fahmimsh/FlowMeter-ESP32-Slave-RP2040-Master/Hardware_Design/master.pdf

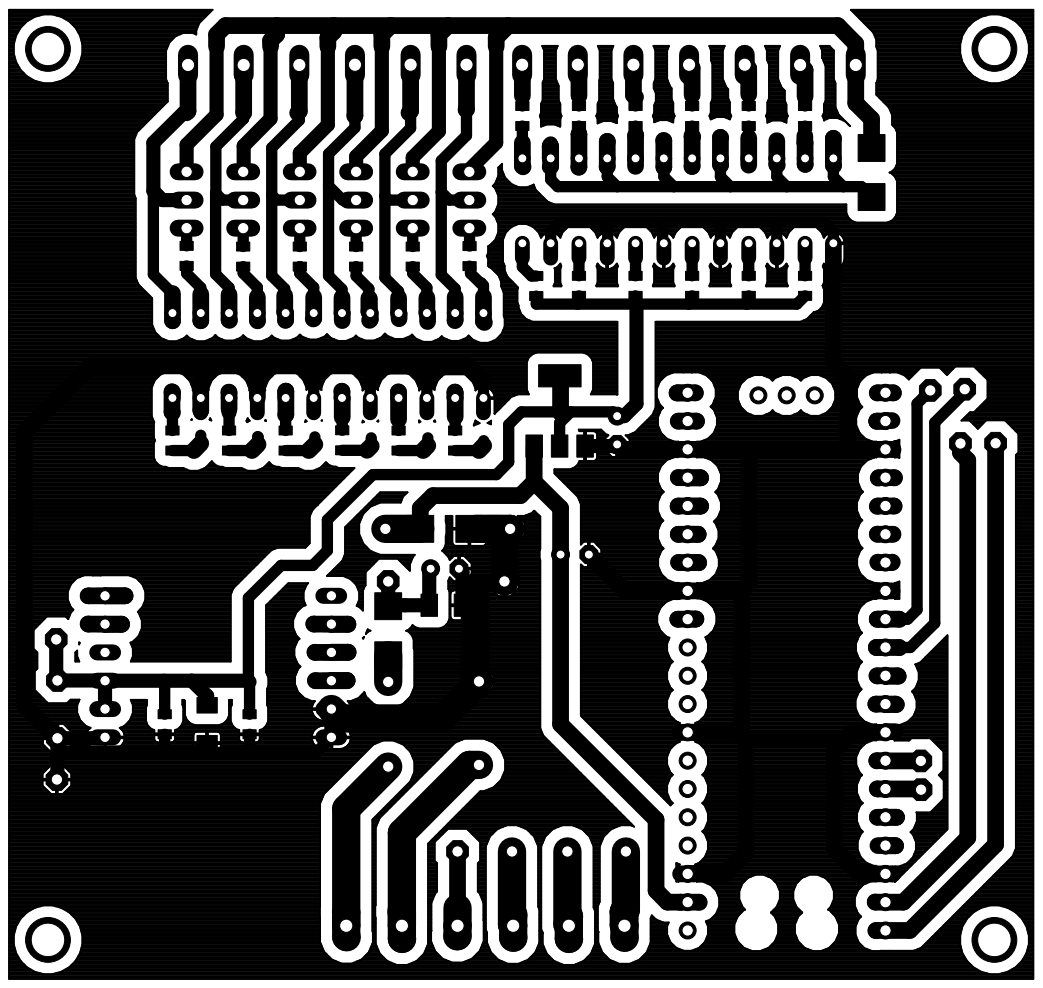
[picture p23: page 1]
