fahmimsh/FlowMeter-ESP32-Slave-RP2040-Master/Hardware_Design/SlaveMCU.pdf

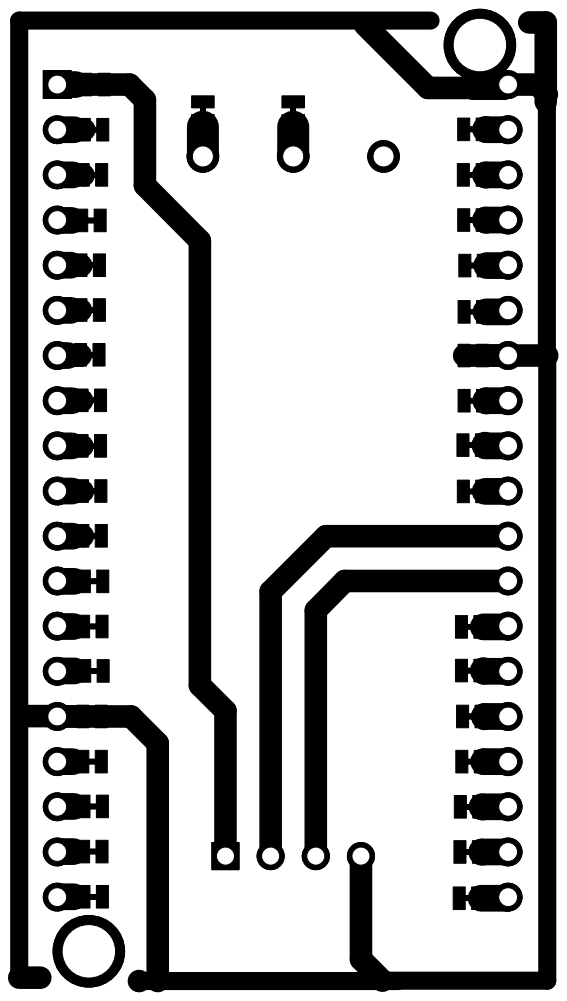
[picture p24: page 1]
