fahmimsh/FlowMeter-ESP32-Slave-RP2040-Master/Hardware_Design/ETH_Design_ESP32.brd

## EAGLE design Hardware_Design/ETH_Design_ESP32.brd (2024-11-11)

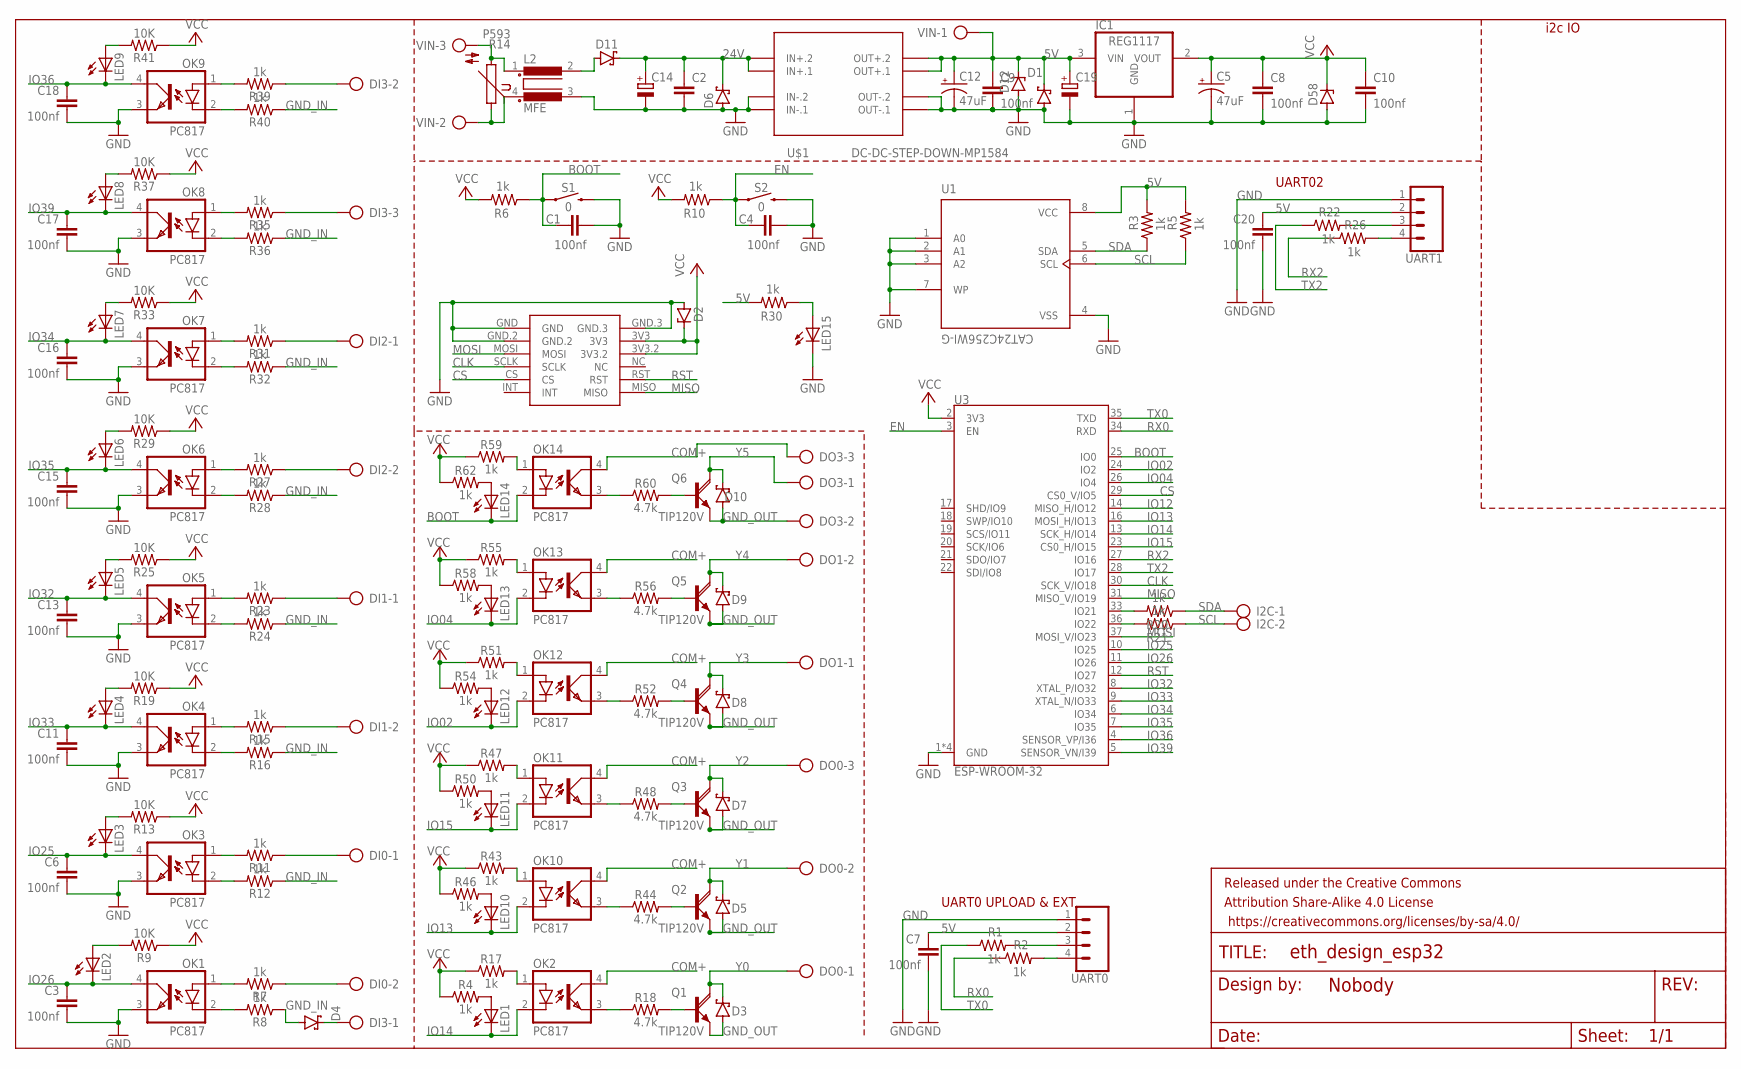
[picture p25: schematic ETH_Design_ESP32.sch]

Parts:
C1, C3, C4, C6, C7, C8, C9, C10, C11, C13, C15, C16, C17, C18, C20: 100nf; 0805
C2: C-EUC1206K; C1206K
C5, C12: 47uF; EIA3528
C14, C19: CPOL-EUE2.5-7; E2,5-7
D1, D3, D4, D5, D6, D7, D8, D9, D10, D11: SCHOTTKY-DIODESMD; SMB
D2, D12, D58: ZENER-DIODESOD80C; SOD80C
DI0, DI1, DI2: AK500/2
DI3: AK500/3
DO0, DO3: AK500/3
DO1: AK500/2
FRAME1: FRAME-LETTERNO_PACKAGE; DUMMY
I2C: AK500/2
IC1: REG1117; SOT223
L2: MFE
LED1, LED2, LED3, LED4, LED5, LED6, LED7, LED8, LED9, LED10, LED11, LED12, LED13, LED14, LED15: LEDCHIPLED_0805; CHIPLED_0805
OK1, OK2, OK3, OK4, OK5, OK6, OK7, OK8, OK9, OK10, OK11, OK12, OK13, OK14: PC817; DIL04
Q1, Q2, Q3, Q4, Q5, Q6: TIP120V; TO220AV
R1, R2, R3, R4, R5, R6, R7, R8, R10, R11, R12, R15, R16, R17, R20, R21, R22, R23, R24, R26, R27, R28, R30, R31, R32, R35, R36, R39, R40, R43, R46, R47, R50, R51, R54, R55, R58, R59, R62: 1k; 0805
R9, R13, R19, R25, R29, R33, R37, R41: 10K; 0805
R14: P593
R18, R44, R48, R52, R56, R60: 4.7k; 0805
S1, S2: 0; TACTILE_SWITCH_PTH_6.0MM_KIT
U1: CAT24C256WI-G; SOIC127P600X175-8N
U3: ESP-WROOM-32
U$1: DC-DC-STEP-DOWN-MP1584
U$2: MINI_W5500
UART0, UART1: CONN_04POLAR; MOLEX-1X4
VIN: AK500/3

Connections:
5V: C7.1, C9.1, C12.A (+), C19.+, C20.1, D1.C, D12.C, IC1.3 (VIN), R3.2, R5.2, R30.2, U1.8 (VCC), U$1.OUT+.1, U$1.OUT+.2, UART0.2, UART1.2, VIN.1
24V: C2.1, C14.+, D6.C, D11.C, U$1.IN+.1, U$1.IN+.2
BOOT: C1.2, LED14.C, OK14.2 (C), R6.1, S1.1, U3.25 (IO0)
CLK: U3.30 (SCK_V/IO18), U$2.SCLK
COM+: DO3.3, OK2.4 (COL), OK10.4 (COL), OK11.4 (COL), OK12.4 (COL), OK13.4 (COL), OK14.4 (COL)
CS: U3.29 (CS0_V/IO5), U$2.CS
EN: C4.2, R10.1, S2.1, U3.3 (EN)
GND: C1.1, C2.2, C3.2, C4.1, C5.C (-), C6.2, C7.2, C8.2, C9.2, C10.2, C11.2, C12.C (-), C13.2, C14.-, C15.2, C16.2, C17.2, C18.2, C19.-, C20.2, D1.A, D2.A, D6.A, D12.A, D58.A, IC1.1 (GND), L2.3 (4), LED15.C, OK1.3 (EMIT), OK3.3 (EMIT), OK4.3 (EMIT), OK5.3 (EMIT), OK6.3 (EMIT), OK7.3 (EMIT), OK8.3 (EMIT), OK9.3 (EMIT), S1.3 (2), S2.3 (2), U1.1 (A0), U1.2 (A1), U1.3 (A2), U1.4 (VSS), U1.7 (WP), U3.1 (GND), U3.15 (GND), U3.38 (GND), U3.GND, U$1.IN-.1, U$1.IN-.2, U$1.OUT-.1, U$1.OUT-.2, U$2.GND, U$2.GND.2, U$2.GND.3, UART0.1, UART1.1
GND_IN: D4.A, R8.1, R12.1, R16.1, R24.1, R28.1, R32.1, R36.1, R40.1
GND_OUT: D3.A, D5.A, D7.A, D8.A, D9.A, D10.A, DO3.2, Q1.E, Q2.E, Q3.E, Q4.E, Q5.E, Q6.E
IO02: LED12.C, OK12.2 (C), U3.24 (IO2)
IO04: LED13.C, OK13.2 (C), U3.26 (IO4)
IO12: U3.14 (MISO_H/IO12)
IO13: LED10.C, OK10.2 (C), U3.16 (MOSI_H/IO13)
IO14: LED1.C, OK2.2 (C), U3.13 (SCK_H/IO14)
IO15: LED11.C, OK11.2 (C), U3.23 (CS0_H/IO15)
IO25: C6.1, LED3.C, OK3.4 (COL), U3.10 (IO25)
IO26: C3.1, LED2.C, OK1.4 (COL), U3.11 (IO26)
IO32: C13.1, LED5.C, OK5.4 (COL), U3.8 (XTAL_P/IO32)
IO33: C11.1, LED4.C, OK4.4 (COL), U3.9 (XTAL_N/IO33)
IO34: C16.1, LED7.C, OK7.4 (COL), U3.6 (IO34)
IO35: C15.1, LED6.C, OK6.4 (COL), U3.7 (IO35)
IO36: C18.1, LED9.C, OK9.4 (COL), U3.4 (SENSOR_VP/I36)
IO39: C17.1, LED8.C, OK8.4 (COL), U3.5 (SENSOR_VN/I39)
MISO: U3.31 (MISO_V/IO19), U$2.MISO
MOSI: U3.37 (MOSI_V/IO23), U$2.MOSI
unnamed: R1.2, UART0.3
unnamed: R2.2, UART0.4
unnamed: R22.2, UART1.3
unnamed: OK1.1 (A), R7.2
unnamed: L2.1, R14.2, VIN.3
unnamed: L2.4 (3), R14.1, VIN.2
unnamed: OK2.1 (A), R17.2
unnamed: LED1.A, R4.2
unnamed: LED8.A, R37.2
unnamed: OK1.2 (C), R8.2
unnamed: LED7.A, R33.2
unnamed: LED6.A, R29.2
unnamed: LED5.A, R25.2
unnamed: R26.2, UART1.4
unnamed: LED15.A, R30.1
unnamed: OK3.1 (A), R11.2
unnamed: OK2.3 (EMIT), R18.1
unnamed: D11.A, L2.2
unnamed: OK3.2 (C), R12.2
unnamed: LED2.A, R9.2
unnamed: LED3.A, R13.2
unnamed: OK4.1 (A), R15.2
unnamed: OK4.2 (C), R16.2
unnamed: LED4.A, R19.2
unnamed: R20.2, U3.33 (IO21)
unnamed: R21.2, U3.36 (IO22)
unnamed: OK5.1 (A), R23.2
unnamed: OK5.2 (C), R24.2
unnamed: OK6.1 (A), R27.2
unnamed: OK6.2 (C), R28.2
unnamed: OK7.1 (A), R31.2
unnamed: OK7.2 (C), R32.2
unnamed: OK8.1 (A), R35.2
unnamed: OK8.2 (C), R36.2
unnamed: OK9.1 (A), R39.2
unnamed: OK9.2 (C), R40.2
unnamed: DI0.2, R7.1
unnamed: Q1.B, R18.2
unnamed: OK10.3 (EMIT), R44.1
unnamed: OK10.1 (A), R43.2
unnamed: LED10.A, R46.2
unnamed: Q2.B, R44.2
unnamed: OK11.3 (EMIT), R48.1
unnamed: OK11.1 (A), R47.2
unnamed: LED11.A, R50.2
unnamed: Q3.B, R48.2
unnamed: OK12.3 (EMIT), R52.1
unnamed: OK12.1 (A), R51.2
unnamed: LED12.A, R54.2
unnamed: LED9.A, R41.2
unnamed: Q4.B, R52.2
unnamed: OK13.3 (EMIT), R56.1
unnamed: DI0.1, R11.1
unnamed: OK13.1 (A), R55.2
unnamed: LED13.A, R58.2
unnamed: DI1.2, R15.1
unnamed: Q5.B, R56.2
unnamed: OK14.3 (EMIT), R60.1
unnamed: DI1.1, R23.1
unnamed: OK14.1 (A), R59.2
unnamed: LED14.A, R62.2
unnamed: DI2.2, R27.1
unnamed: Q6.B, R60.2
unnamed: DI2.1, R31.1
unnamed: DI3.3, R35.1
unnamed: DI3.2, R39.1
unnamed: D4.C, DI3.1
RST: U3.12 (IO27), U$2.RST
RX0: R2.1, U3.34 (RXD)
RX2: R26.1, U3.27 (IO16)
SCL: I2C.2, R5.1, R21.1, U1.6 (SCL)
SDA: I2C.1, R3.1, R20.1, U1.5 (SDA)
TX0: R1.1, U3.35 (TXD)
TX2: R22.1, U3.28 (IO17)
VCC: C5.A (+), C8.1, C10.1, D2.C, D58.C, IC1.2 (VOUT), R4.1, R6.2, R9.1, R10.2, R13.1, R17.1, R19.1, R25.1, R29.1, R33.1, R37.1, R41.1, R43.1, R46.1, R47.1, R50.1, R51.1, R54.1, R55.1, R58.1, R59.1, R62.1, U3.2 (3V3), U$2.3V3, U$2.3V3.2
Y0: D3.C, DO0.1, Q1.C
Y1: D5.C, DO0.2, Q2.C
Y2: D7.C, DO0.3, Q3.C
Y3: D8.C, DO1.1, Q4.C
Y4: D9.C, DO1.2, Q5.C
Y5: D10.C, DO3.1, Q6.C

Notes on the sheet:
UART0 UPLOAD & EXT
i2c IO
UART02

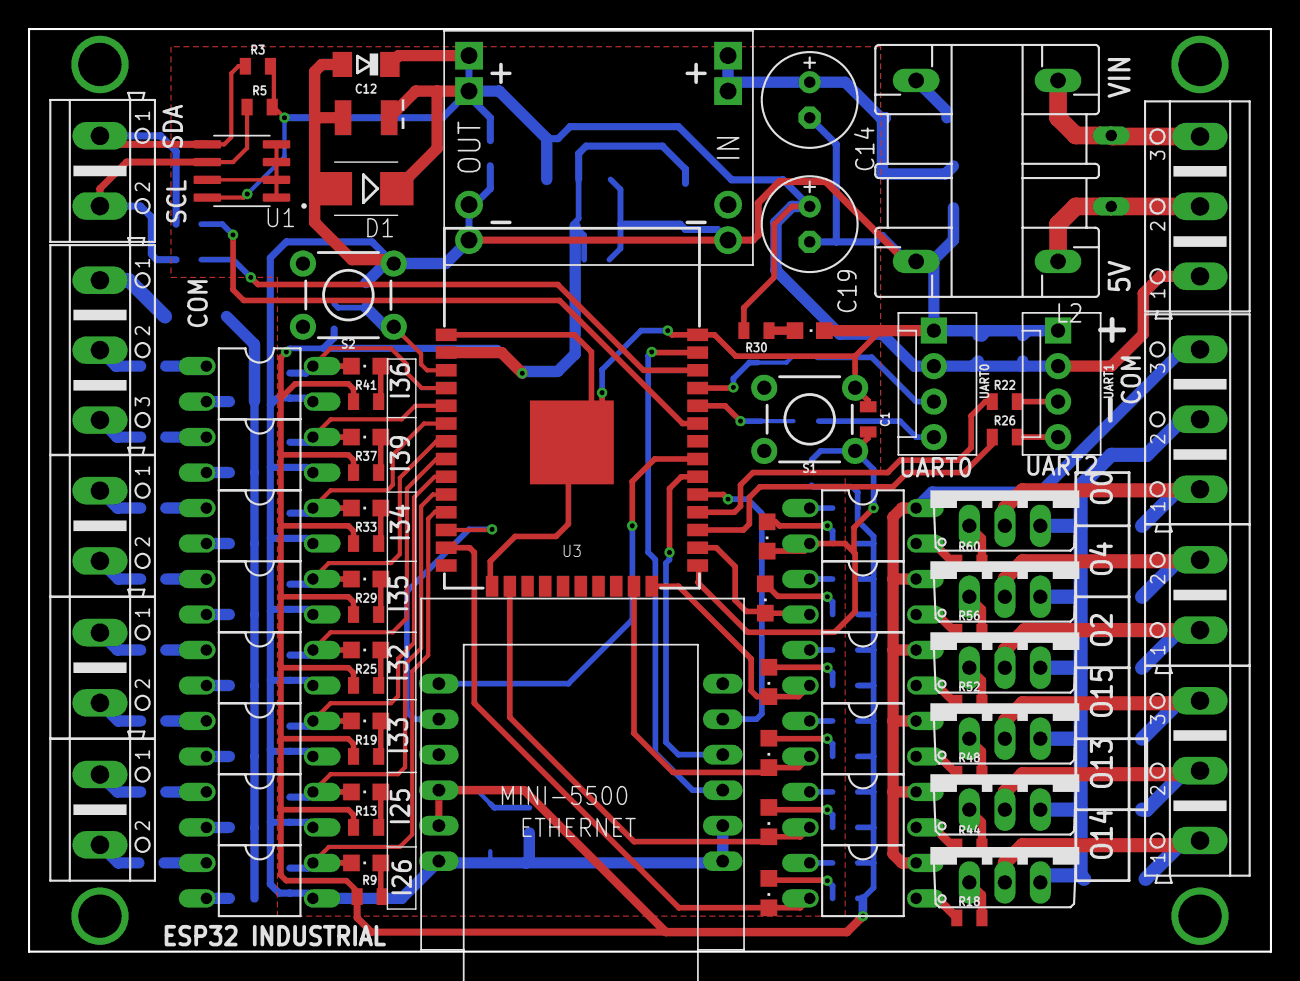
[picture p26: board ETH_Design_ESP32.brd from above]

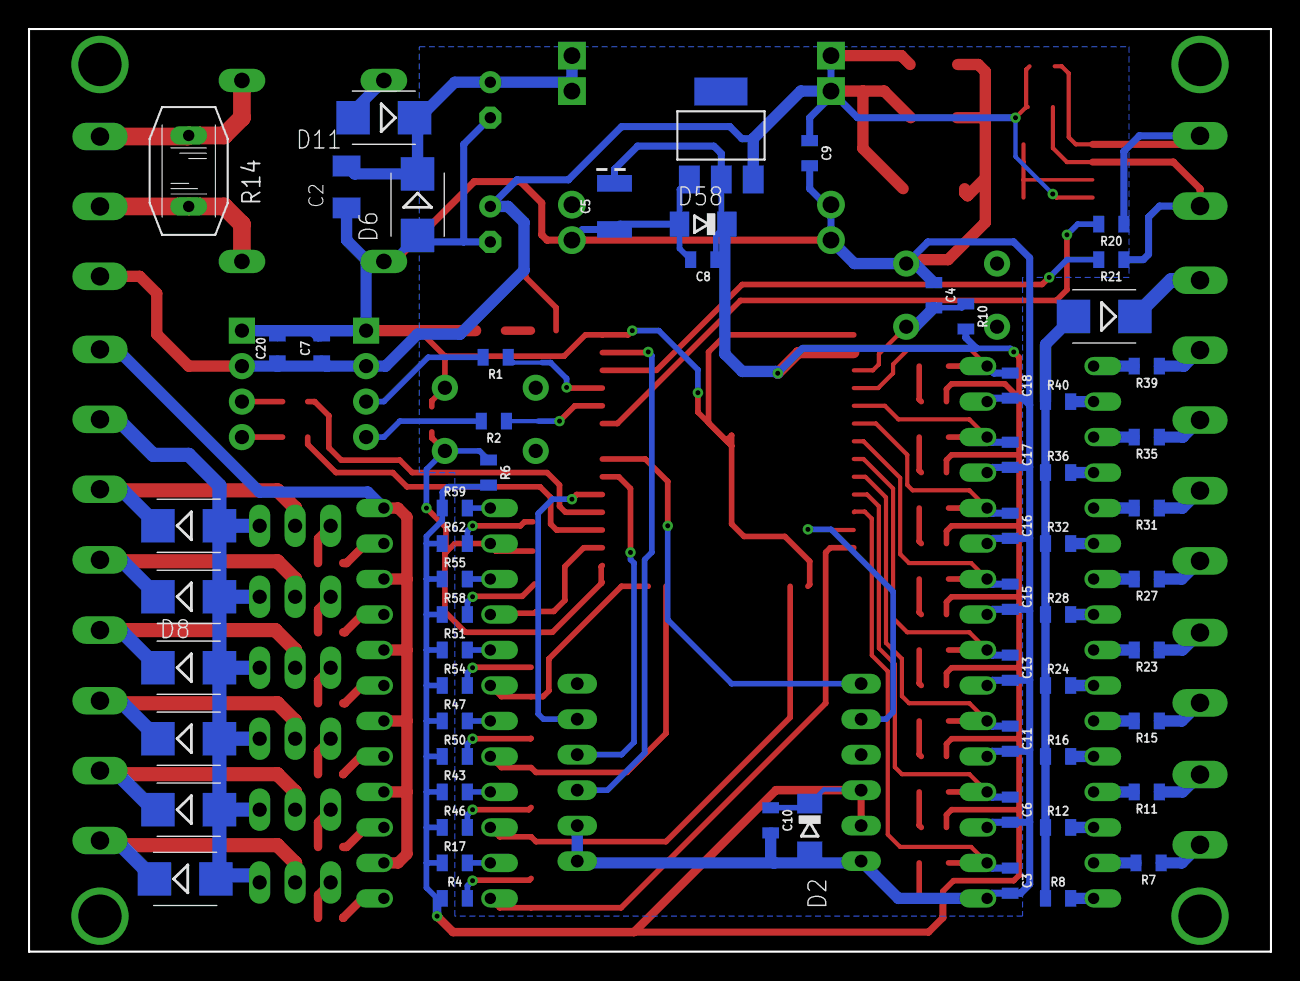
[picture p27: board ETH_Design_ESP32.brd from below]

Board: 2 copper layers, 88.9 x 66.0 mm, 142 parts (63 on the bottom side), 106 nets.
