fahmimsh/FlowMeter-ESP32-Slave-RP2040-Master/Hardware_Design/Slave.brd

## EAGLE design Hardware_Design/Slave.brd (2024-01-31)

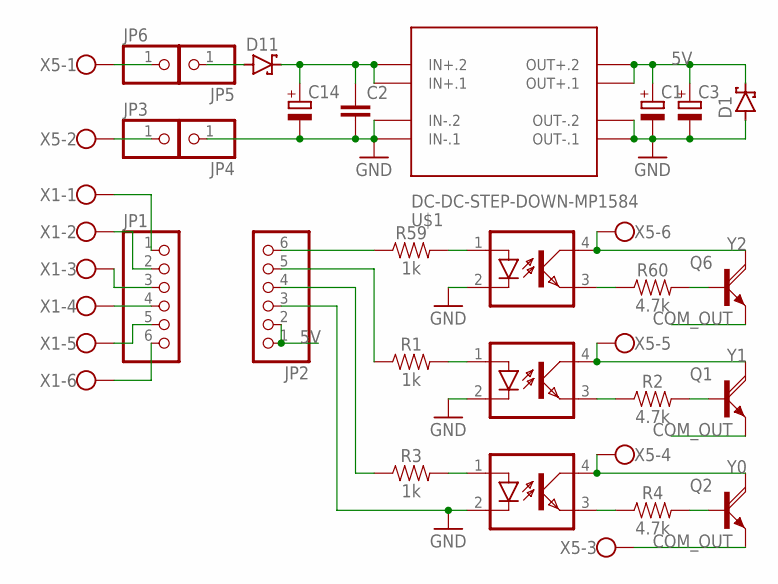
[picture p28: schematic Slave.sch]

Parts:
C1, C3, C14: CPOL-EUE2.5-7; E2,5-7
C2: C-EUC1206K; C1206K
D1, D11: SCHOTTKY-DIODESMD; SMB
JP1, JP2: PINHD-1X6B; 1X06-BIG
JP3, JP4, JP5, JP6: PINHD-1X1; 1X01
OK1, OK2, OK14: PC817; DIL04
Q1, Q2, Q6: TIP120V; TO220AV
R1, R3, R59: 1k; 0805
R2, R4, R60: 4.7k; 0805
U$1: DC-DC-STEP-DOWN-MP1584
X1, X5: W237-136

Connections:
5V: C1.+, C3.+, D1.C, JP2.1, JP2.2, U$1.OUT+.1, U$1.OUT+.2
COM_OUT: Q1.E, Q2.E, Q6.E, X5.3
GND: C1.-, C2.2, C3.-, C14.-, D1.A, JP2.3, JP4.1, OK1.2 (C), OK2.2 (C), OK14.2 (C), U$1.IN-.1, U$1.IN-.2, U$1.OUT-.1, U$1.OUT-.2
unnamed: OK1.3 (EMIT), R2.1
unnamed: OK1.1 (A), R1.2
unnamed: Q1.B, R2.2
unnamed: OK2.3 (EMIT), R4.1
unnamed: OK2.1 (A), R3.2
unnamed: Q2.B, R4.2
unnamed: JP1.6, X1.6
unnamed: JP1.5, X1.5
unnamed: JP1.4, X1.4
unnamed: JP1.3, X1.3
unnamed: JP1.2, X1.2
unnamed: JP1.1, X1.1
unnamed: JP2.6, R59.1
unnamed: JP2.5, R1.1
unnamed: JP2.4, R3.1
unnamed: D11.A, JP5.1
unnamed: JP3.1, X5.2
unnamed: JP6.1, X5.1
unnamed: C2.1, C14.+, D11.C, U$1.IN+.1, U$1.IN+.2
unnamed: OK14.3 (EMIT), R60.1
unnamed: OK14.1 (A), R59.2
unnamed: Q6.B, R60.2
Y0: OK2.4 (COL), Q2.C, X5.4
Y1: OK1.4 (COL), Q1.C, X5.5
Y2: OK14.4 (COL), Q6.C, X5.6

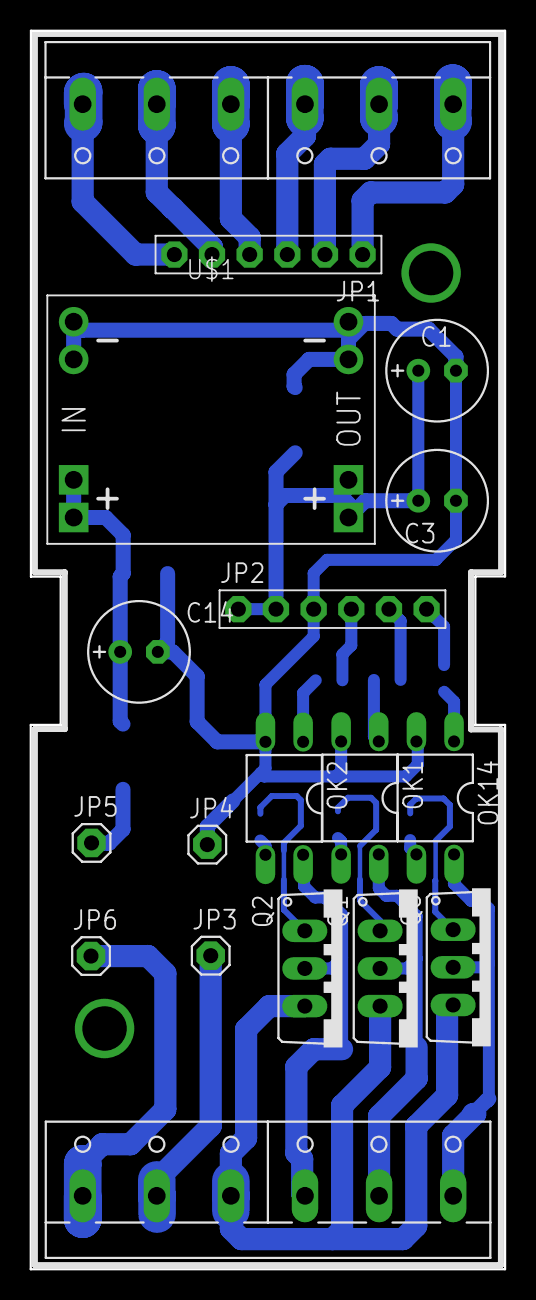
[picture p29: board Slave.brd from above]

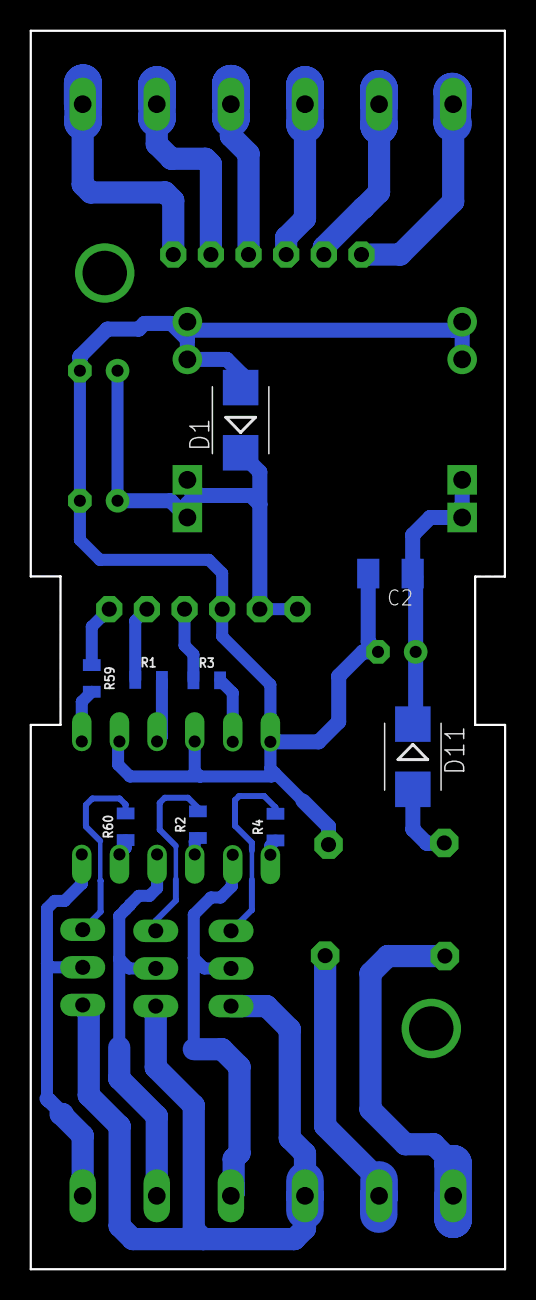
[picture p30: board Slave.brd from below]

Board: 2 copper layers, 32.0 x 83.6 mm, 27 parts (9 on the bottom side), 28 nets.
