fahmimsh/FlowMeter-ESP32-Slave-RP2040-Master/Hardware_Design/SlaveMCU.brd

## EAGLE design Hardware_Design/SlaveMCU.brd (2024-01-31)

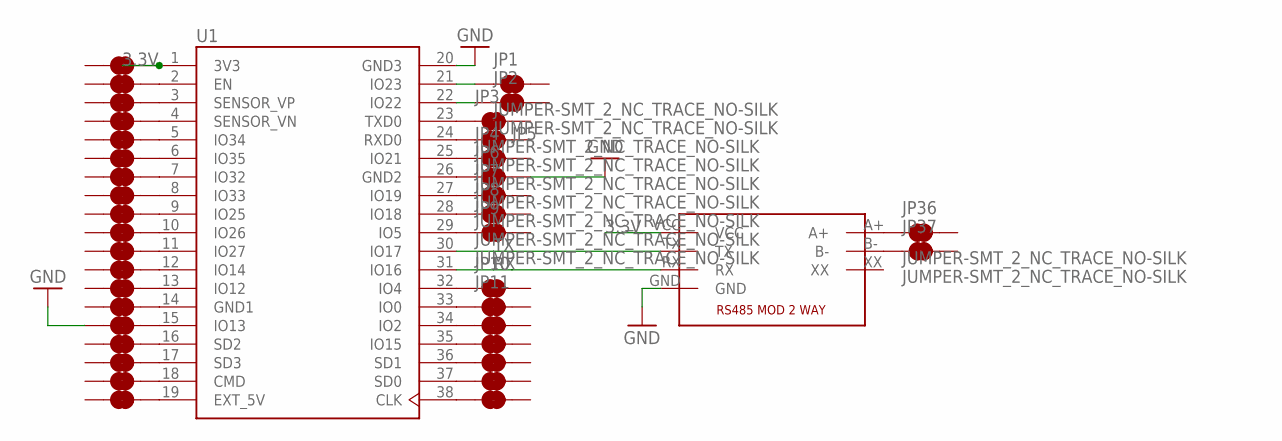
[picture p31: schematic SlaveMCU.sch]

Parts:
JP1, JP2, JP3, JP4, JP5, JP6, JP7, JP8, JP9, JP10, JP11, JP12, JP13, JP14, JP15, JP16, JP17, JP18, JP19, JP20, JP21, JP22, JP23, JP24, JP25, JP26, JP27, JP28, JP29, JP30, JP31, JP32, JP33, JP34, JP35, JP36, JP37: JUMPER-SMT_2_NC_TRACE_NO-SILK; SMT-JUMPER_2_NC_TRACE_NO-SILK
U1: ESP32-DEVKITC-32D; MODULE_ESP32-DEVKITC-32D
U$2: RS485_MODULE

Connections:
3.3V: JP35.2, U1.1 (3V3), U$2.VCC
GND: JP6.2, JP21.1, U1.20 (GND3), U$2.GND
unnamed: JP1.1, U1.21 (IO23)
unnamed: JP4.1, U1.25 (IO21)
unnamed: JP5.1, U1.24 (RXD0)
unnamed: JP6.1, U1.26 (GND2)
unnamed: JP7.1, U1.27 (IO19)
unnamed: JP9.1, U1.29 (IO5)
unnamed: JP10.1, U1.32 (IO4)
unnamed: JP11.1, U1.33 (IO0)
unnamed: JP12.1, U1.34 (IO2)
unnamed: JP13.1, U1.35 (IO15)
unnamed: JP14.1, U1.36 (SD1)
unnamed: JP15.1, U1.37 (SD0)
unnamed: JP16.1, U1.38 (CLK)
unnamed: JP17.2, U1.19 (EXT_5V)
unnamed: JP18.2, U1.18 (CMD)
unnamed: JP19.2, U1.17 (SD3)
unnamed: JP20.2, U1.16 (SD2)
unnamed: JP21.2, U1.15 (IO13)
unnamed: JP22.2, U1.14 (GND1)
unnamed: JP23.2, U1.13 (IO12)
unnamed: JP24.2, U1.12 (IO14)
unnamed: JP26.2, U1.10 (IO26)
unnamed: JP27.2, U1.9 (IO25)
unnamed: JP28.2, U1.8 (IO33)
unnamed: JP29.2, U1.7 (IO32)
unnamed: JP30.2, U1.5 (IO34)
unnamed: JP31.2, U1.6 (IO35)
unnamed: JP32.2, U1.4 (SENSOR_VN)
unnamed: JP33.2, U1.3 (SENSOR_VP)
unnamed: JP34.2, U1.2 (EN)
unnamed: JP25.2, U1.11 (IO27)
unnamed: JP8.1, U1.28 (IO18)
unnamed: JP3.1, U1.23 (TXD0)
unnamed: JP2.1, U1.22 (IO22)
unnamed: JP36.1, U$2.A+
unnamed: JP37.1, U$2.B-
RX: U1.31 (IO16), U$2.RX
TX: U1.30 (IO17), U$2.TX

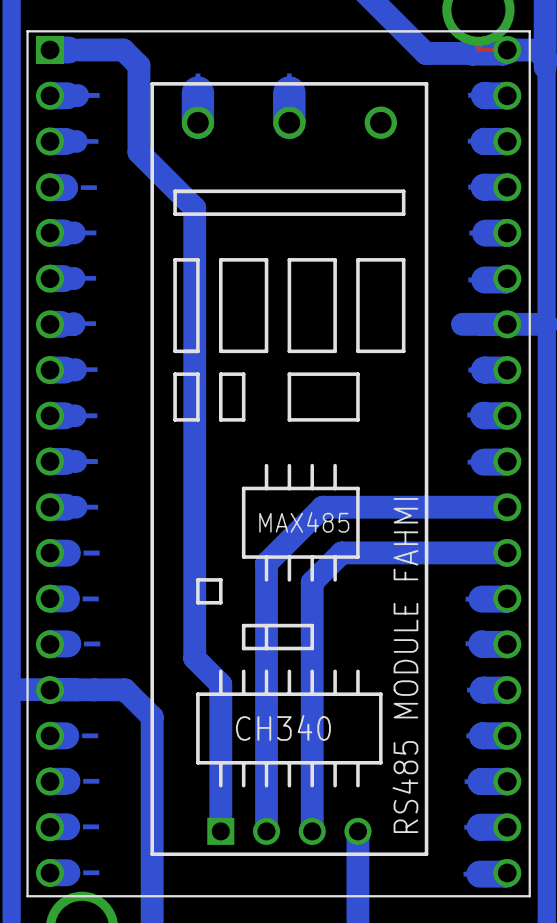
[picture p32: board SlaveMCU.brd from above]

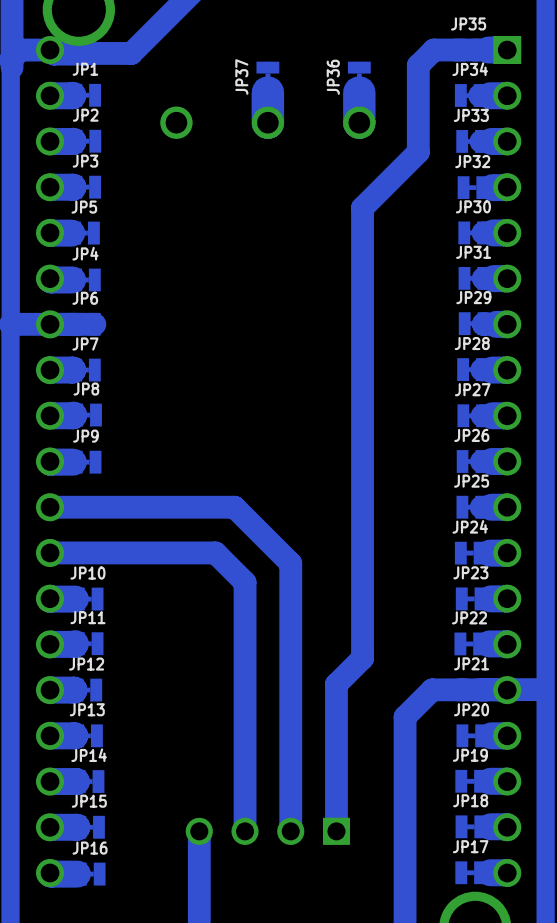
[picture p33: board SlaveMCU.brd from below]

Board: 2 copper layers, 39 parts (37 on the bottom side), 40 nets.
