fahmimsh/FlowMeter-ESP32-Slave-RP2040-Master/Hardware_Design/master.brd

## EAGLE design Hardware_Design/master.brd (2024-01-31)

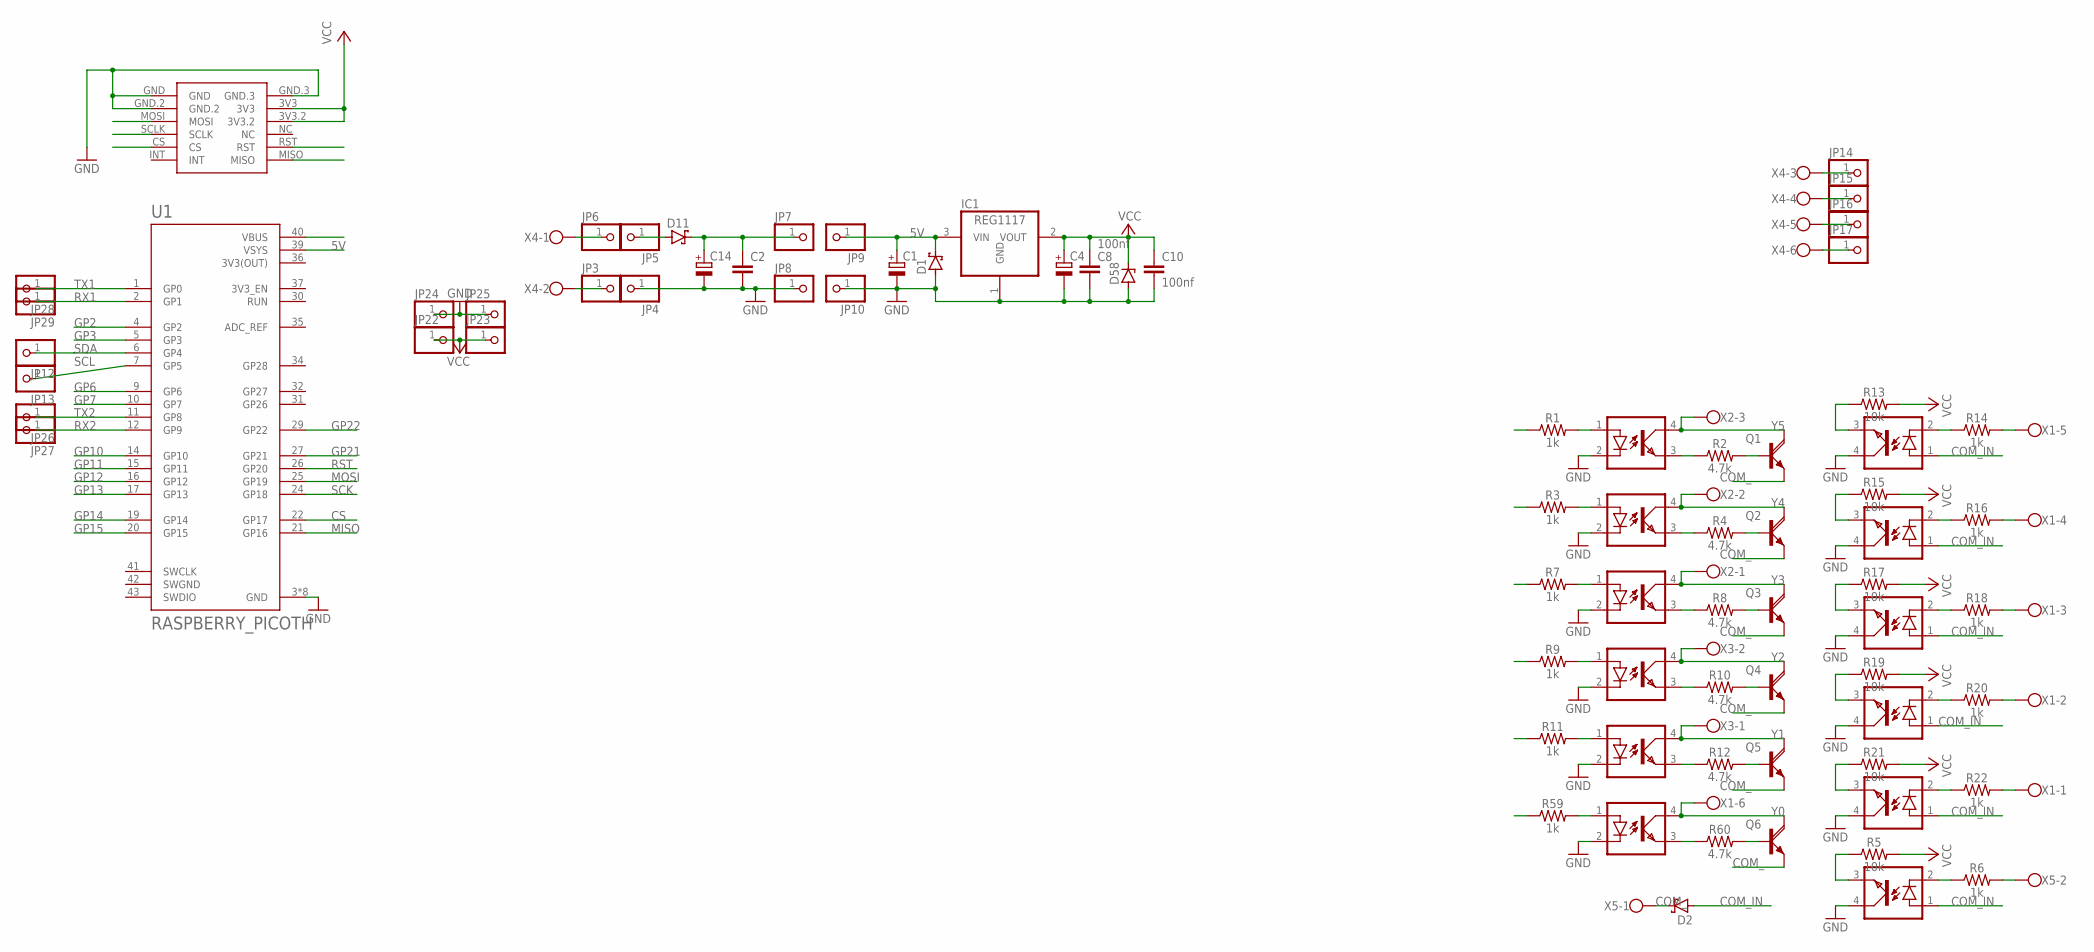
[picture p34: schematic master.sch]

Parts:
C1, C4, C14: CPOL-EUE2.5-7; E2,5-7
C2: C-EUC1206K; C1206K
C8, C10: 100nf; 0805
D1, D2, D11: SCHOTTKY-DIODESMD; SMB
D58: ZENER-DIODESOD80C; SOD80C
IC1: REG1117; SOT223
JP3, JP4, JP5, JP6, JP7, JP8, JP9, JP10, JP12, JP13, JP14, JP15, JP16, JP17, JP22, JP23, JP24, JP25, JP26, JP27, JP28, JP29: PINHD-1X1; 1X01
OK1, OK2, OK3, OK4, OK5, OK6, OK7, OK8, OK9, OK10, OK11, OK14: PC817; DIL04
Q1, Q2, Q3, Q4, Q5, Q6: TIP120V; TO220AV
R1, R3, R6, R7, R9, R11, R14, R16, R18, R20, R22, R59: 1k; 0805
R2, R4, R8, R10, R12, R60: 4.7k; 0805
R5, R13, R15, R17, R19, R21: 10k; 0805
U1: RASPBERRY_PICOTH; PICO-PKG-TH
U$2: MINI_W5500
X1, X4: W237-136
X2: W237-103
X3, X5: W237-102

Connections:
3V3(OUT): U1.36 (3V3(OUT))
5V: C1.+, D1.C, IC1.3 (VIN), JP9.1, U1.39 (VSYS)
COM_: D2.C, Q1.E, Q2.E, Q3.E, Q4.E, Q5.E, Q6.E, X5.1
COM_IN: D2.A, OK3.1 (A), OK7.1 (A), OK8.1 (A), OK9.1 (A), OK10.1 (A), OK11.1 (A)
CS: U1.22 (GP17)
GND: C1.-, C2.2, C4.-, C8.2, C10.2, C14.-, D1.A, D58.A, IC1.1 (GND), JP4.1, JP8.1, JP10.1, JP24.1, JP25.1, OK1.2 (C), OK2.2 (C), OK3.4 (COL), OK4.2 (C), OK5.2 (C), OK6.2 (C), OK7.4 (COL), OK8.4 (COL), OK9.4 (COL), OK10.4 (COL), OK11.4 (COL), OK14.2 (C), U1.3 (GND), U1.8 (GND), U1.13 (GND), U1.18 (GND), U1.23 (GND), U1.28 (GND), U1.33 (GND), U1.38 (GND), U$2.GND, U$2.GND.2, U$2.GND.3
GP2: U1.4 (GP2)
GP3: U1.5 (GP3)
GP6: U1.9 (GP6)
GP7: U1.10 (GP7)
GP10: U1.14 (GP10)
GP11: U1.15 (GP11)
GP12: U1.16 (GP12)
GP13: U1.17 (GP13)
GP14: U1.19 (GP14)
GP15: U1.20 (GP15)
GP21: U1.27 (GP21)
GP22: U1.29 (GP22)
MISO: U1.21 (GP16)
MOSI: U1.25 (GP19)
unnamed: OK1.3 (EMIT), R2.1
unnamed: OK1.1 (A), R1.2
unnamed: Q1.B, R2.2
unnamed: OK2.3 (EMIT), R4.1
unnamed: OK2.1 (A), R3.2
unnamed: Q2.B, R4.2
unnamed: OK8.2 (C), R16.1
unnamed: OK9.2 (C), R18.1
unnamed: OK4.3 (EMIT), R8.1
unnamed: OK4.1 (A), R7.2
unnamed: Q3.B, R8.2
unnamed: OK5.3 (EMIT), R10.1
unnamed: OK5.1 (A), R9.2
unnamed: Q4.B, R10.2
unnamed: OK6.3 (EMIT), R12.1
unnamed: JP6.1, X4.1
unnamed: D11.A, JP5.1
unnamed: JP3.1, X4.2
unnamed: OK6.1 (A), R11.2
unnamed: Q5.B, R12.2
unnamed: C2.1, C14.+, D11.C, JP7.1
unnamed: OK7.2 (C), R14.1
unnamed: OK10.2 (C), R20.1
unnamed: OK11.2 (C), R22.1
unnamed: OK3.2 (C), R6.1
unnamed: OK7.3 (EMIT), R13.1
unnamed: OK8.3 (EMIT), R15.1
unnamed: OK9.3 (EMIT), R17.1
unnamed: OK10.3 (EMIT), R19.1
unnamed: JP14.1, X4.3
unnamed: JP15.1, X4.4
unnamed: JP16.1, X4.5
unnamed: JP17.1, X4.6
unnamed: OK11.3 (EMIT), R21.1
unnamed: OK3.3 (EMIT), R5.1
unnamed: R14.2, X1.5
unnamed: R16.2, X1.4
unnamed: R18.2, X1.3
unnamed: R20.2, X1.2
unnamed: R22.2, X1.1
unnamed: R6.2, X5.2
unnamed: OK14.3 (EMIT), R60.1
unnamed: OK14.1 (A), R59.2
unnamed: Q6.B, R60.2
RST: U1.26 (GP20)
RX1: JP29.1, U1.2 (GP1)
RX2: JP27.1, U1.12 (GP9)
SCK: U1.24 (GP18)
SCL: JP13.1, U1.7 (GP5)
SDA: JP12.1, U1.6 (GP4)
SWGND: U1.42 (SWGND)
TX1: JP28.1, U1.1 (GP0)
TX2: JP26.1, U1.11 (GP8)
VCC: C4.+, C8.1, C10.1, D58.C, IC1.2 (VOUT), JP22.1, JP23.1, R5.2, R13.2, R15.2, R17.2, R19.2, R21.2, U$2.3V3, U$2.3V3.2
Y0: OK14.4 (COL), Q6.C, X1.6
Y1: OK6.4 (COL), Q5.C, X3.1
Y2: OK5.4 (COL), Q4.C, X3.2
Y3: OK4.4 (COL), Q3.C, X2.1
Y4: OK2.4 (COL), Q2.C, X2.2
Y5: OK1.4 (COL), Q1.C, X2.3

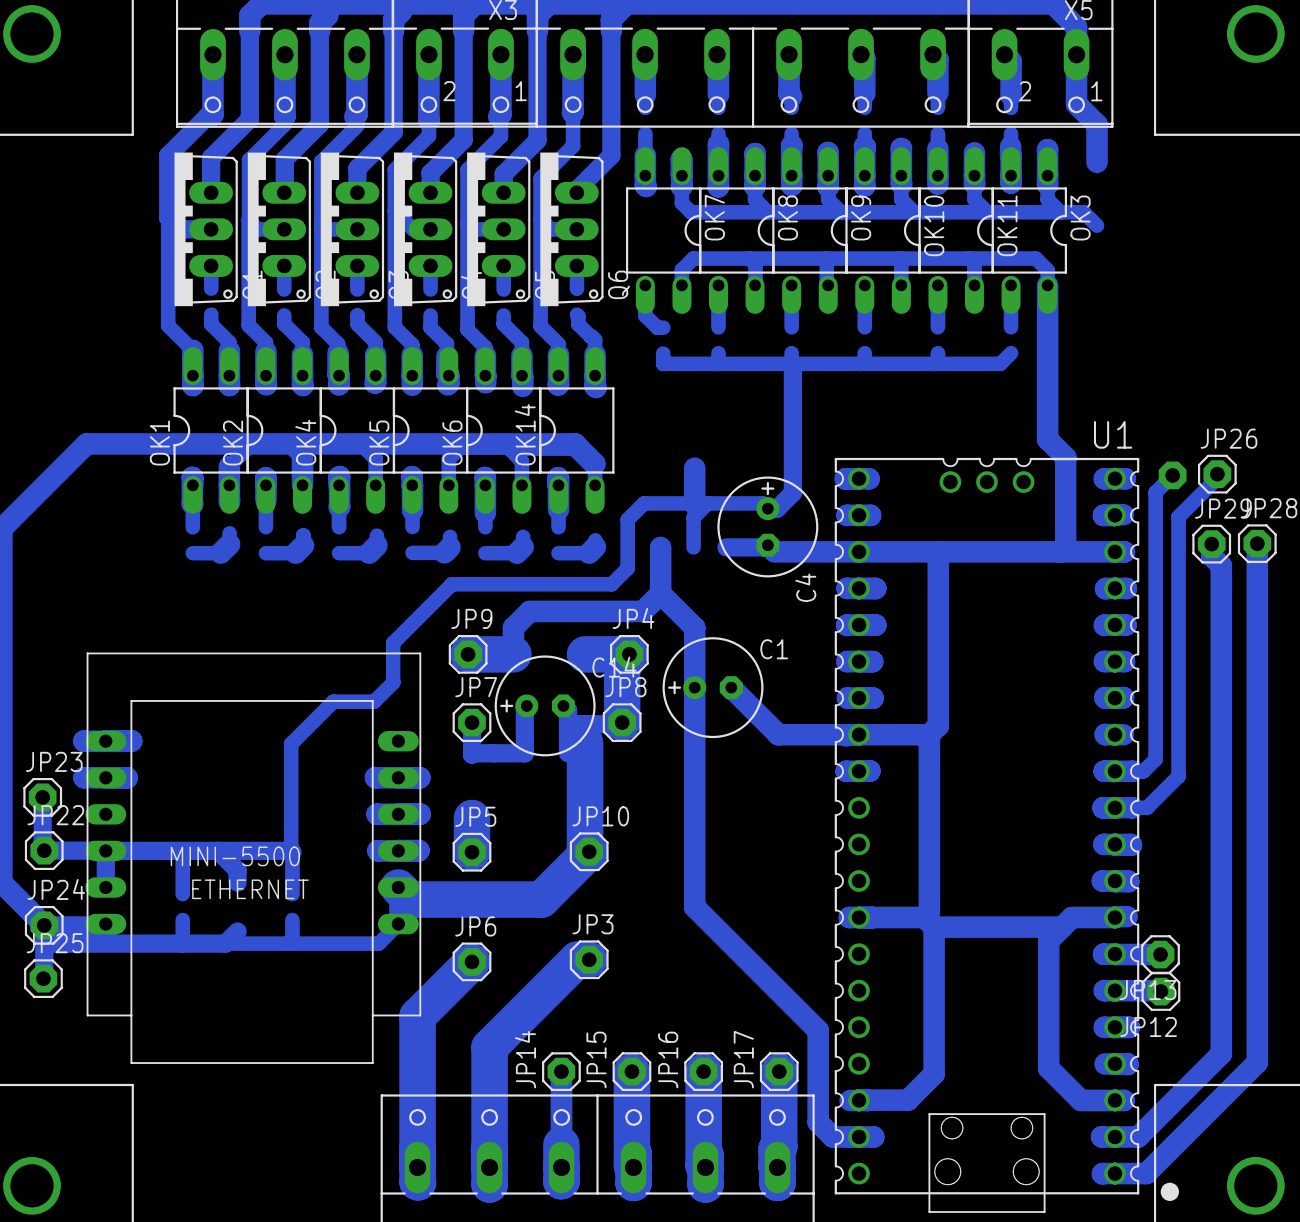
[picture p35: board master.brd from above]

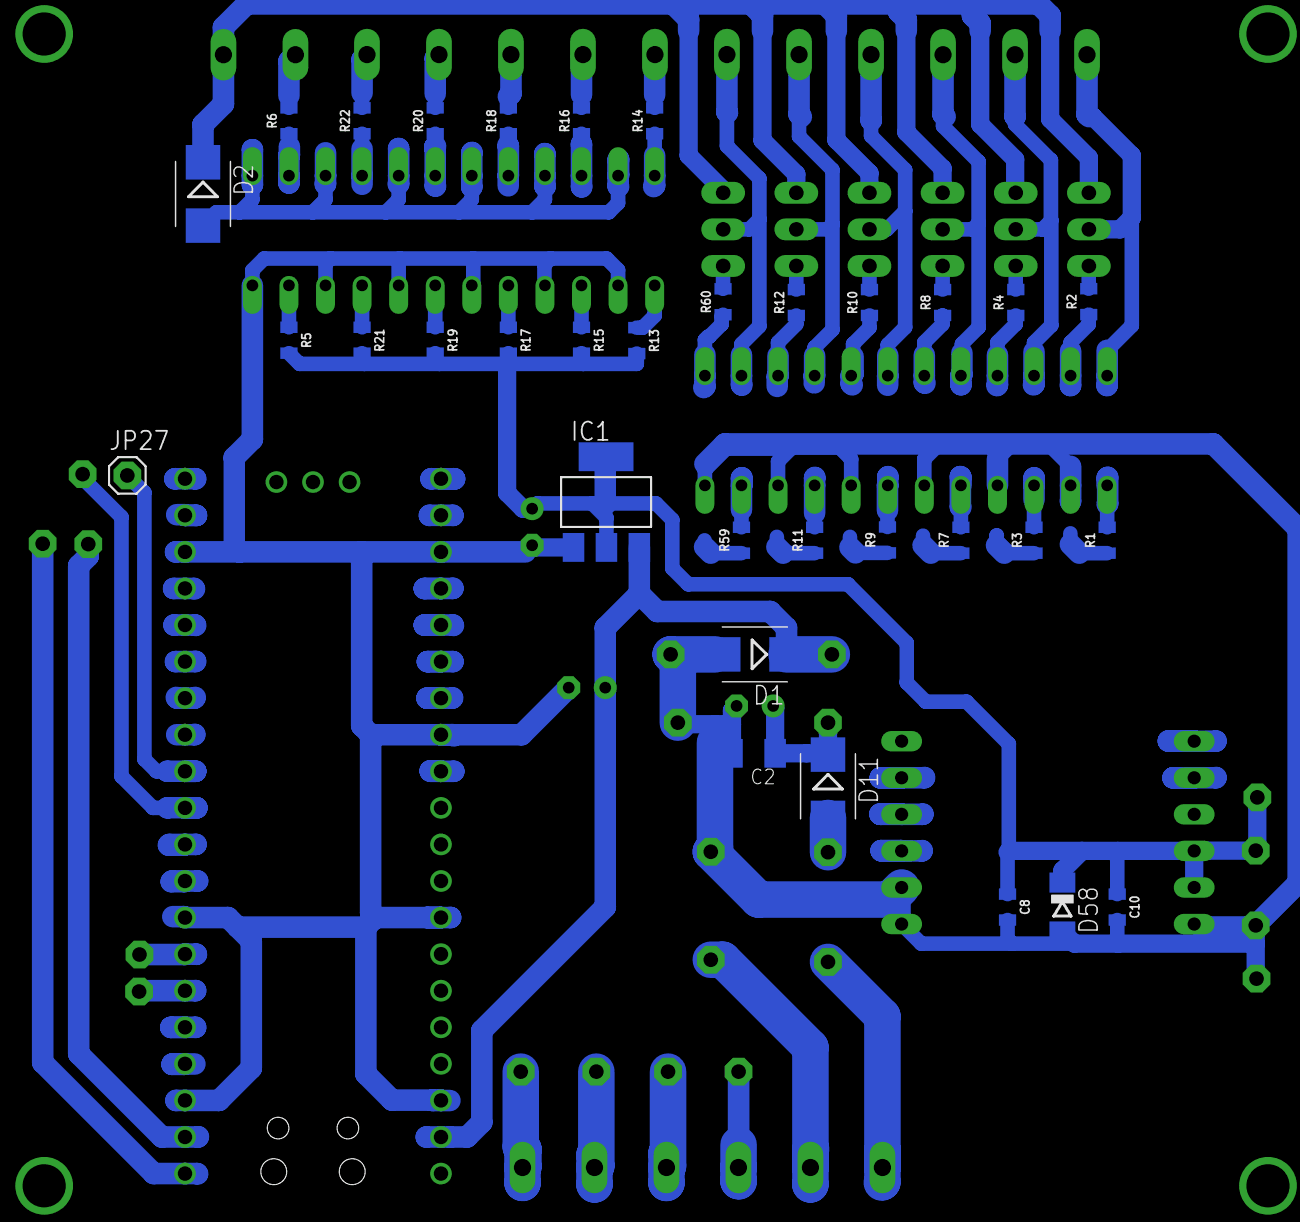
[picture p36: board master.brd from below]

Board: 2 copper layers, 82 parts (33 on the bottom side), 61 nets.
