fahmimsh/FlowMeter-ESP32-Slave-RP2040-Master/(commit log)

2024-06-03 update scada
    [GUI_FL1_FL2.g, GUI_FL3_FL4_FL5.g]
2024-11-11 add flow meter
